4strium/Radar-Recul-ENIB/VCO.asc

C: cap; 15nF
M1: nmos; 2N7002
R1: res; 4.7k
R2: res; 2.2k
R3: res; 2.2k
R4: res; 1.61k
R5: res; 1k
R6: res; 9.44k
R7: res; 10k
R8: res; 27k
R9: res; 1k
R10: res; 23.8k
U1: TL081
U2: TL081
U3: TL081
U4: TL081
V1: voltage; 0.074
V2: voltage; 15
V3: voltage; 15
Named nets: 0, Vcc+, Vcc-, Vs3, Vs1, Vs2, Vs, Ve2
Vs1 = Vcc+ si Vs3 < Vcc+ * (R4/R5+R4)
Vs1 = Vcc- si Vs3 > Vcc- * (R4/R5+R4)
Vs3 = (-Vs2/(15*10^-9)*R4)*t avec t le temps
On peut donc jouer sur la pente de la courbe en sortie
.tran 5m uic
Offset de 0.6V
