4strium/Radar-Recul-ENIB/Boucle_Retroaction_Condensateur.asc

C: cap; 15nF
R6: res; 18k
U1: TL081
V2: voltage; 15
V3: voltage; 15
Vs2: voltage; 2
Named nets: 0, Vs3, Vcc+, Vcc-
.tran 10ms uic
.ic V(C1)=0
