4strium/Radar-Recul-ENIB/Conditionneur.asc

R1: res; 10k
R2: res; 27k
R3: res; 23.8k
R4: res; 1k
U1: TL081
V1: voltage; 0
V2: voltage; 15
V3: voltage; 15
Named nets: 0, Vcc+, Vcc-, S, E
.dc V1 0.074 0.575 0.01
