4strium/Radar-Recul-ENIB/Transistor_Commutation.asc

M1: nmos; 2N7002
R3: res; 100k
Ve: voltage; 3
Vgs: voltage; PULSE(-13 13 0 1ns 1ns 1ms 2ms 20)
Named nets: 0, Vgs, VDS
.tran  5m
