4strium/Radar-Recul-ENIB/Conditionneur_1ereTentative.asc

R1: res; 1.77k
R2: res; 4.7k
R3: res; 1k
R4: res; 1k
R5: res; 1k
R6: res; 1k
R7: res; 1k
U1: UniversalOpAmp
U2: UniversalOpAmp
V1: voltage; 0
V2: voltage; 15
V3: voltage; 15
V4: voltage; 2.2
Named nets: 0, Vcc+, Vcc-, S, Off, E
.dc V1 0.074 0.575 0.01
Rajouter un offset de V4
Inverser et amplifier le signal V1 de -R2/R1
