4strium/Radar-Recul-ENIB/(commit log)

2024-11-16 Updated input voltage of sumador
2024-11-24 Update .gitignore and add new schematic files for feedback loop and transistor switching
2024-11-25 Added VCO (voltage-controlled oscillator)
2024-12-03 Modify VCO and feedback loop schematic, and add project report
2024-12-07 Update mathematical expressions and adjust resistor values in VCO.asc for accurate simulation results
2024-12-15 Update VCO.asc wiring and enhance README.md with detailed component descriptions and images
2024-12-19 Enhance README.md by clarifying resistor roles and centering additional images for better visual presentation
    [Tableur Projet Radar de recul 2024.ods]
